Flying-team-KTH/Solfar/README.md

# Solfar
Repository for the solfar aircraft
