Flying-team-KTH/Solfar/BMS/KiCAD_BMS_EK_AW/plots/KiCAD_BMS_EK_AW__Assembly.pdf

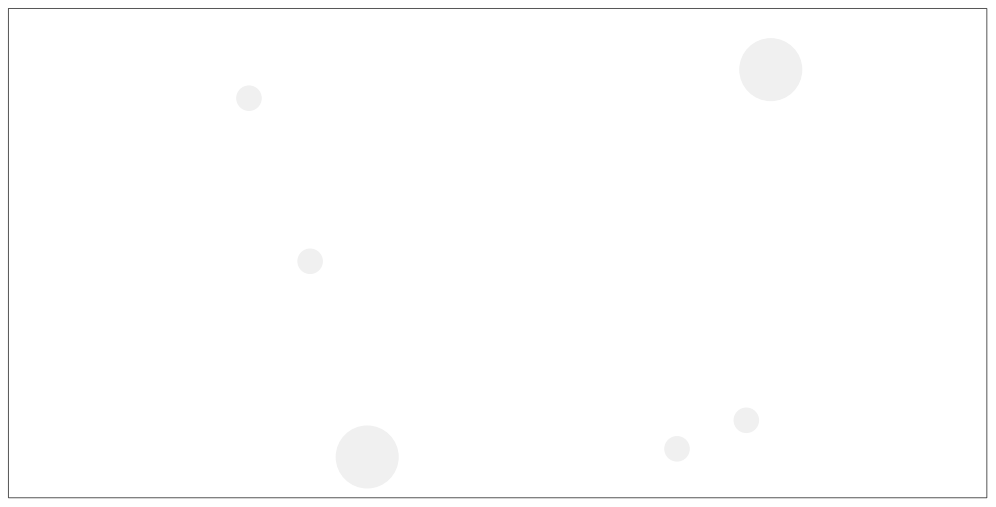
[picture p3: page 1]
D Date: KiCad; E.D.A. 9.0.4 Size: A4; Rev:; Id: /1 Title: File: KiCAD_BMS_EK_AW.kicad_pcb Sheet: Black; And; White; TOP; Board2Pdf:; Black; TOP -; Page

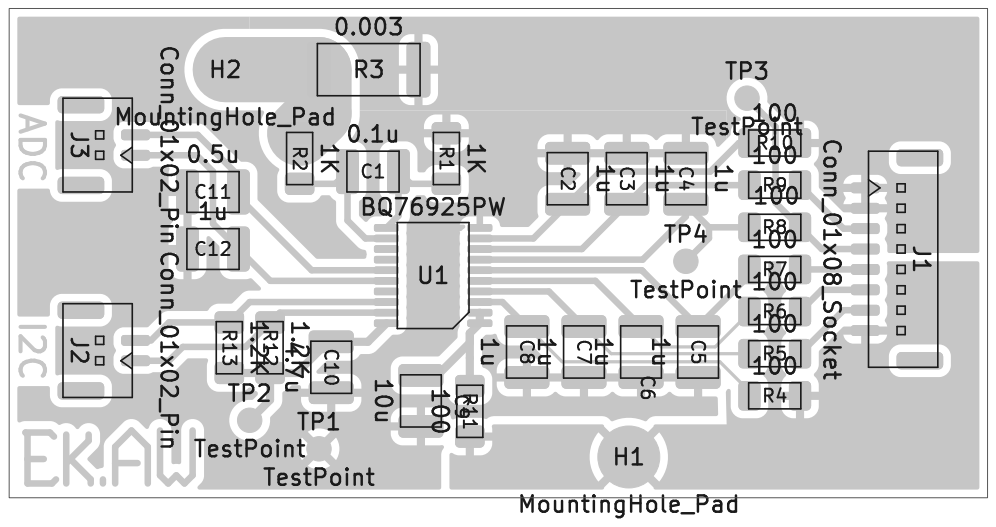
[picture p4: page 2]
