Flying-team-KTH/Solfar/BMS/KiCAD_BMS_EK_AW/gerbers/KiCAD_BMS_EK_AW.pdf

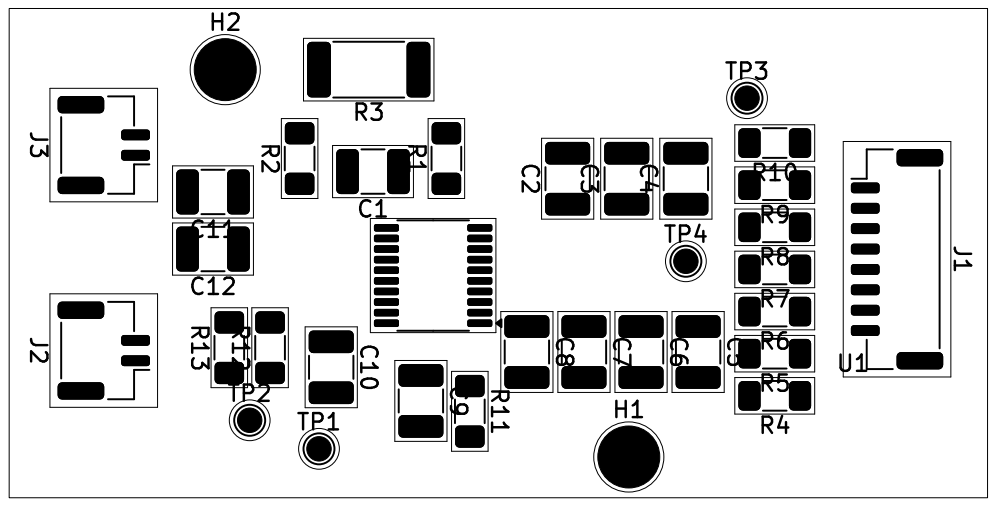
[picture p5: page 1]
