Flying-team-KTH/Solfar/BMS/KiCAD_BMS_EK_AW/pdf/bq76925_board_layout.pdf

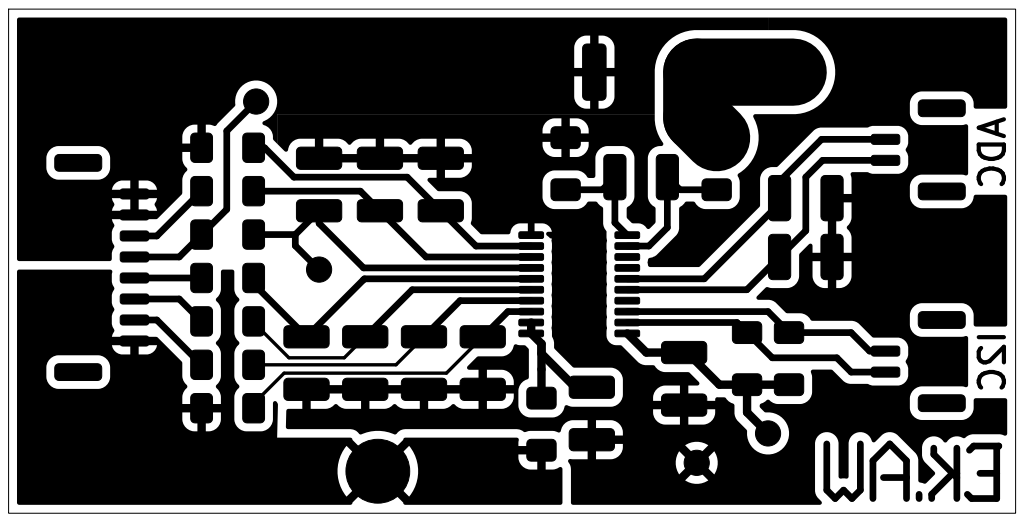
[picture p6: page 1]
