Flying-team-KTH/Solfar/BMS/KiCAD_BMS_EK_AW/pdf/bq76925_board_schem.pdf

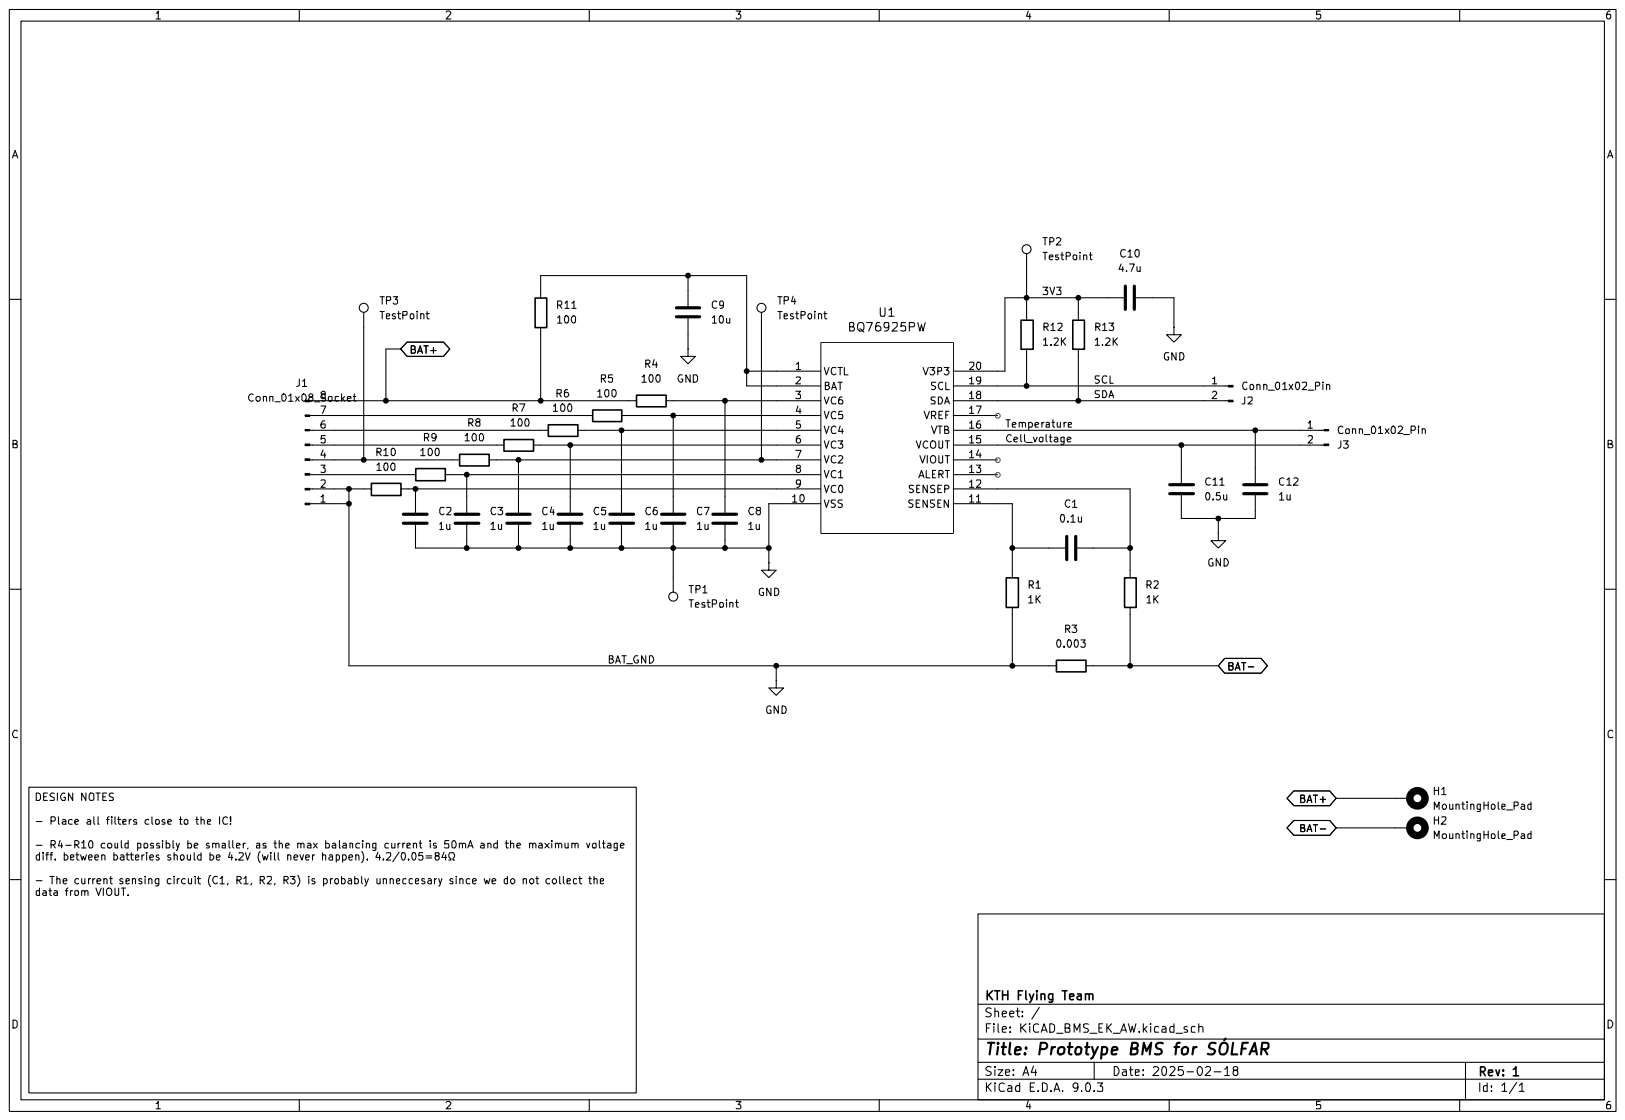
[picture p7: page 1]
