Flying-team-KTH/Solfar/BMS/KiCAD_BMS_EK_AW/KiCAD_BMS_EK_AW.kicad_pcb

## KiCad design BMS/KiCAD_BMS_EK_AW/KiCAD_BMS_EK_AW.kicad_pcb (2026-01-28)

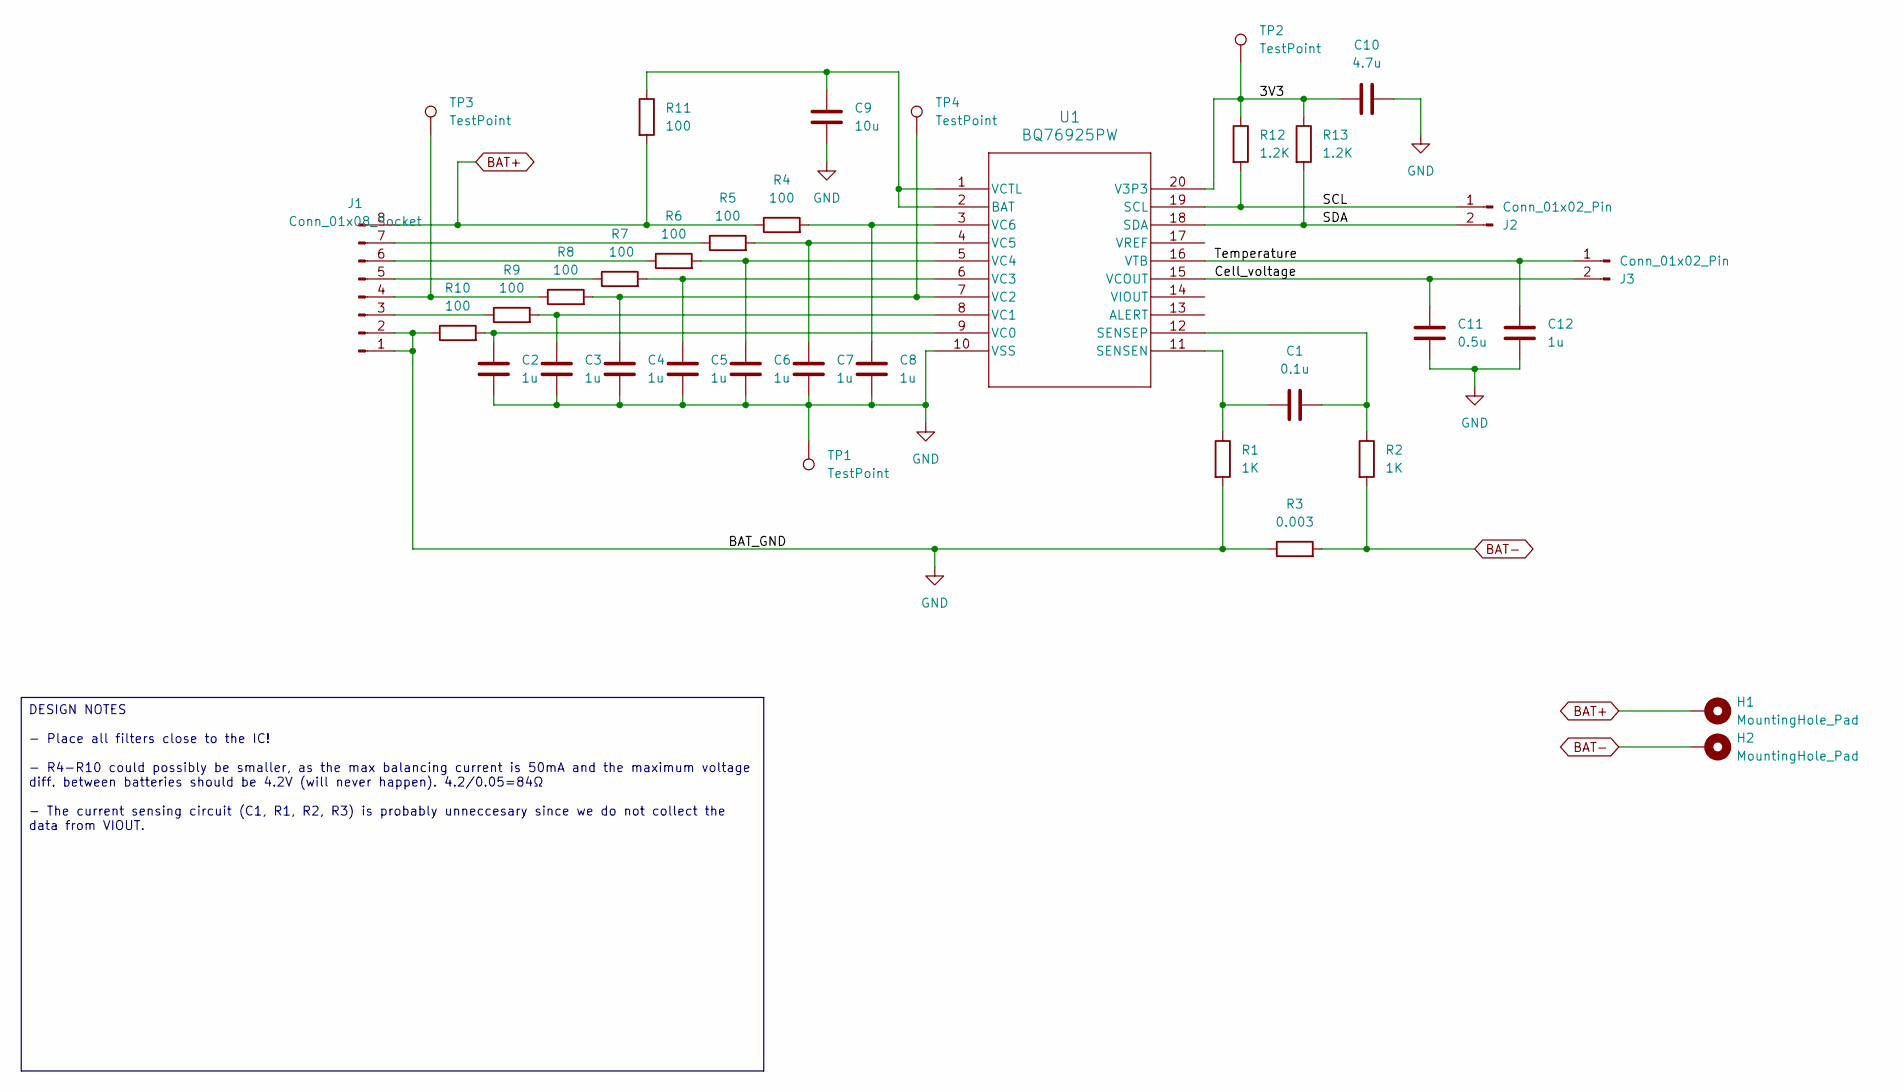
[picture p8: schematic KiCAD_BMS_EK_AW.kicad_sch, Prototype BMS for SÓLFAR]

Parts:
C1: 0.1u; C_1210_3225Metric_Pad1.33x2.70mm_HandSolder
C2, C3, C4, C5, C6, C7, C8, C12: 1u; C_1210_3225Metric_Pad1.33x2.70mm_HandSolder
C9: 10u; C_1210_3225Metric_Pad1.33x2.70mm_HandSolder
C10: 4.7u; C_1210_3225Metric_Pad1.33x2.70mm_HandSolder
C11: 0.5u; C_1210_3225Metric_Pad1.33x2.70mm_HandSolder
H1, H2: MountingHole_Pad; MountingHole_2.2mm_M2_DIN965_Pad
J1: Conn_01x08_Socket; JST_GH_BM08B-GHS-TBT_1x08-1MP_P1.25mm_Vertical
J2, J3: Conn_01x02_Pin; JST_GH_BM02B-GHS-TBT_1x02-1MP_P1.25mm_Vertical
R1, R2: 1K; R_1206_3216Metric_Pad1.30x1.75mm_HandSolder
R3: 0.003; R_2512_6332Metric_Pad1.40x3.35mm_HandSolder
R4, R5, R6, R7, R8, R9, R10, R11: 100; R_1206_3216Metric_Pad1.30x1.75mm_HandSolder
R12, R13: 1.2K; R_1206_3216Metric_Pad1.30x1.75mm_HandSolder
TP1, TP2, TP3, TP4: TestPoint; TestPoint_THTPad_D1.5mm_Drill0.7mm
U1: BQ76925PW; TSSOP-20_4.4x6.5mm_P0.65mm

Connections:
/3V3: C10.1, R12.1, R13.1, TP2.1, U1.20 (V3P3)
/Cell_voltage: C11.1, J3.2, U1.15 (VCOUT)
/SCL: J2.1, R12.2, U1.19 (SCL)
/SDA: J2.2, R13.2, U1.18 (SDA)
/Temperature: C12.1, J3.1, U1.16 (VTB)
BAT+: H1.1, J1.8, R4.1, R11.2
BAT-: H2.1, R2.2, R3.2
GND: C2.2, C3.2, C4.2, C5.2, C6.2, C7.2, C8.2, C9.2, C10.2, C11.2, C12.2, J1.1, J1.2, R1.2, R3.1, R10.1, TP1.1, U1.10 (VSS)
unnamed: J1.3, R9.1
unnamed: J1.4, R8.1, TP3.1
unnamed: J1.5, R7.1
unnamed: J1.6, R6.1
unnamed: J1.7, R5.1
unnamed: C9.1, R11.1, U1.1 (VCTL), U1.2 (BAT)
unnamed: C1.1, R1.1, U1.11 (SENSEN)
unnamed: C1.2, R2.1, U1.12 (SENSEP)
unnamed: C2.1, R10.2, U1.9 (VC0)
unnamed: C3.1, R9.2, U1.8 (VC1)
unnamed: C4.1, R8.2, TP4.1, U1.7 (VC2)
unnamed: C5.1, R7.2, U1.6 (VC3)
unnamed: C6.1, R6.2, U1.5 (VC4)
unnamed: C7.1, R5.2, U1.4 (VC5)
unnamed: C8.1, R4.2, U1.3 (VC6)

Notes on the sheet:
DESIGN NOTES - Place all filters close to the IC! - R4-R10 could possibly be smaller, as the max balancing current is 50mA and the maximum voltage diff. between batteries should be 4.2V (will never happen). 4.2/0.05=84Ω - The current sensing circuit (C1, R1, R2, R3) is probably unneccesary since we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

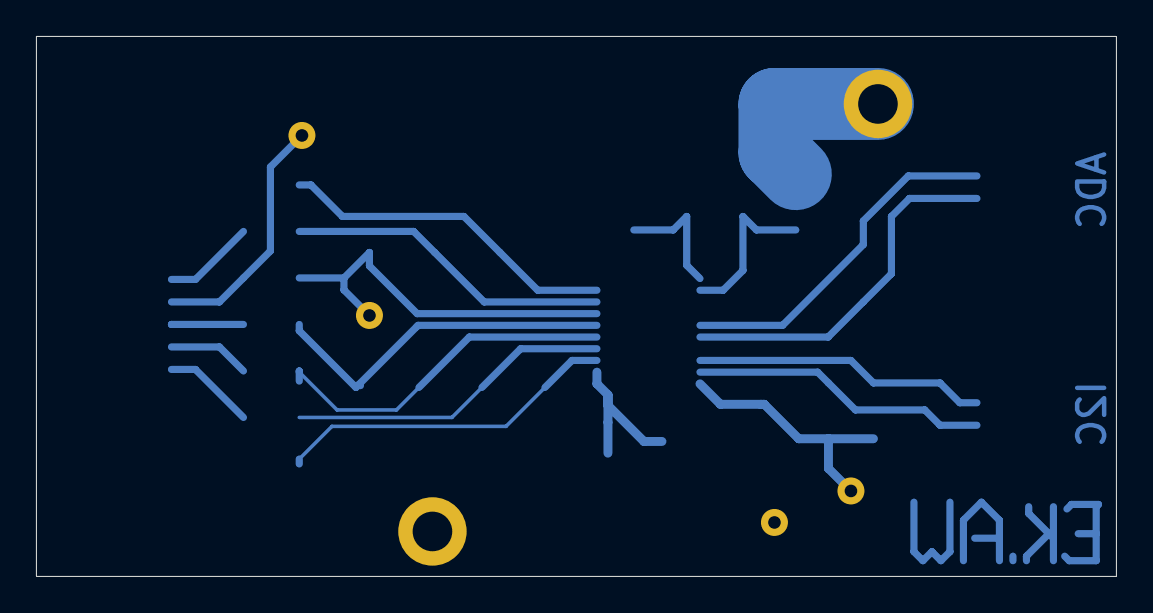
[picture p9: board KiCAD_BMS_EK_AW.kicad_pcb from above]

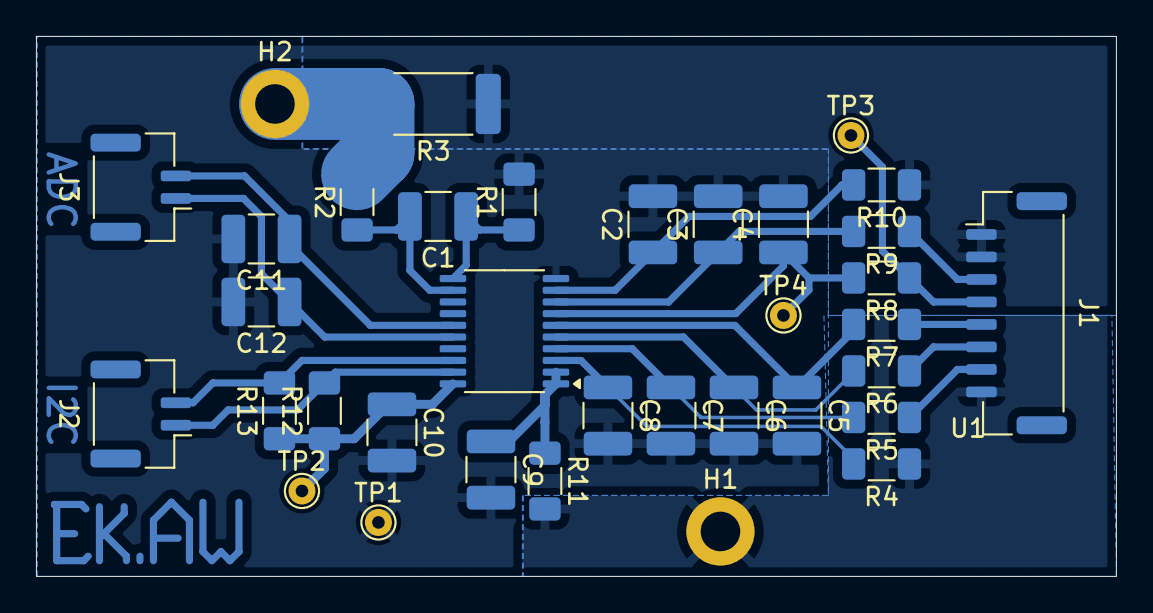
[picture p10: board KiCAD_BMS_EK_AW.kicad_pcb from below]

Board: 2 copper layers, 60.0 x 30.0 mm, 35 parts (35 on the bottom side), 23 nets.
