Flying-team-KTH/Solfar/(commit log)

2026-01-28 Added code and report for solfar BMS system
2026-01-28 Added ignore for general system files and KiCad
2026-01-28 KiCad project as described in AW,EK report
    [KiCAD_BMS_EK_AW.kicad_pcb, KiCAD_BMS_EK_AW.kicad_sch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]
